Duncanla/SCI-BREADBRD-MVK/SCI-BREADBRD_avdd.sch

## KiCad design SCI-BREADBRD_avdd.sch (2012-05-08)

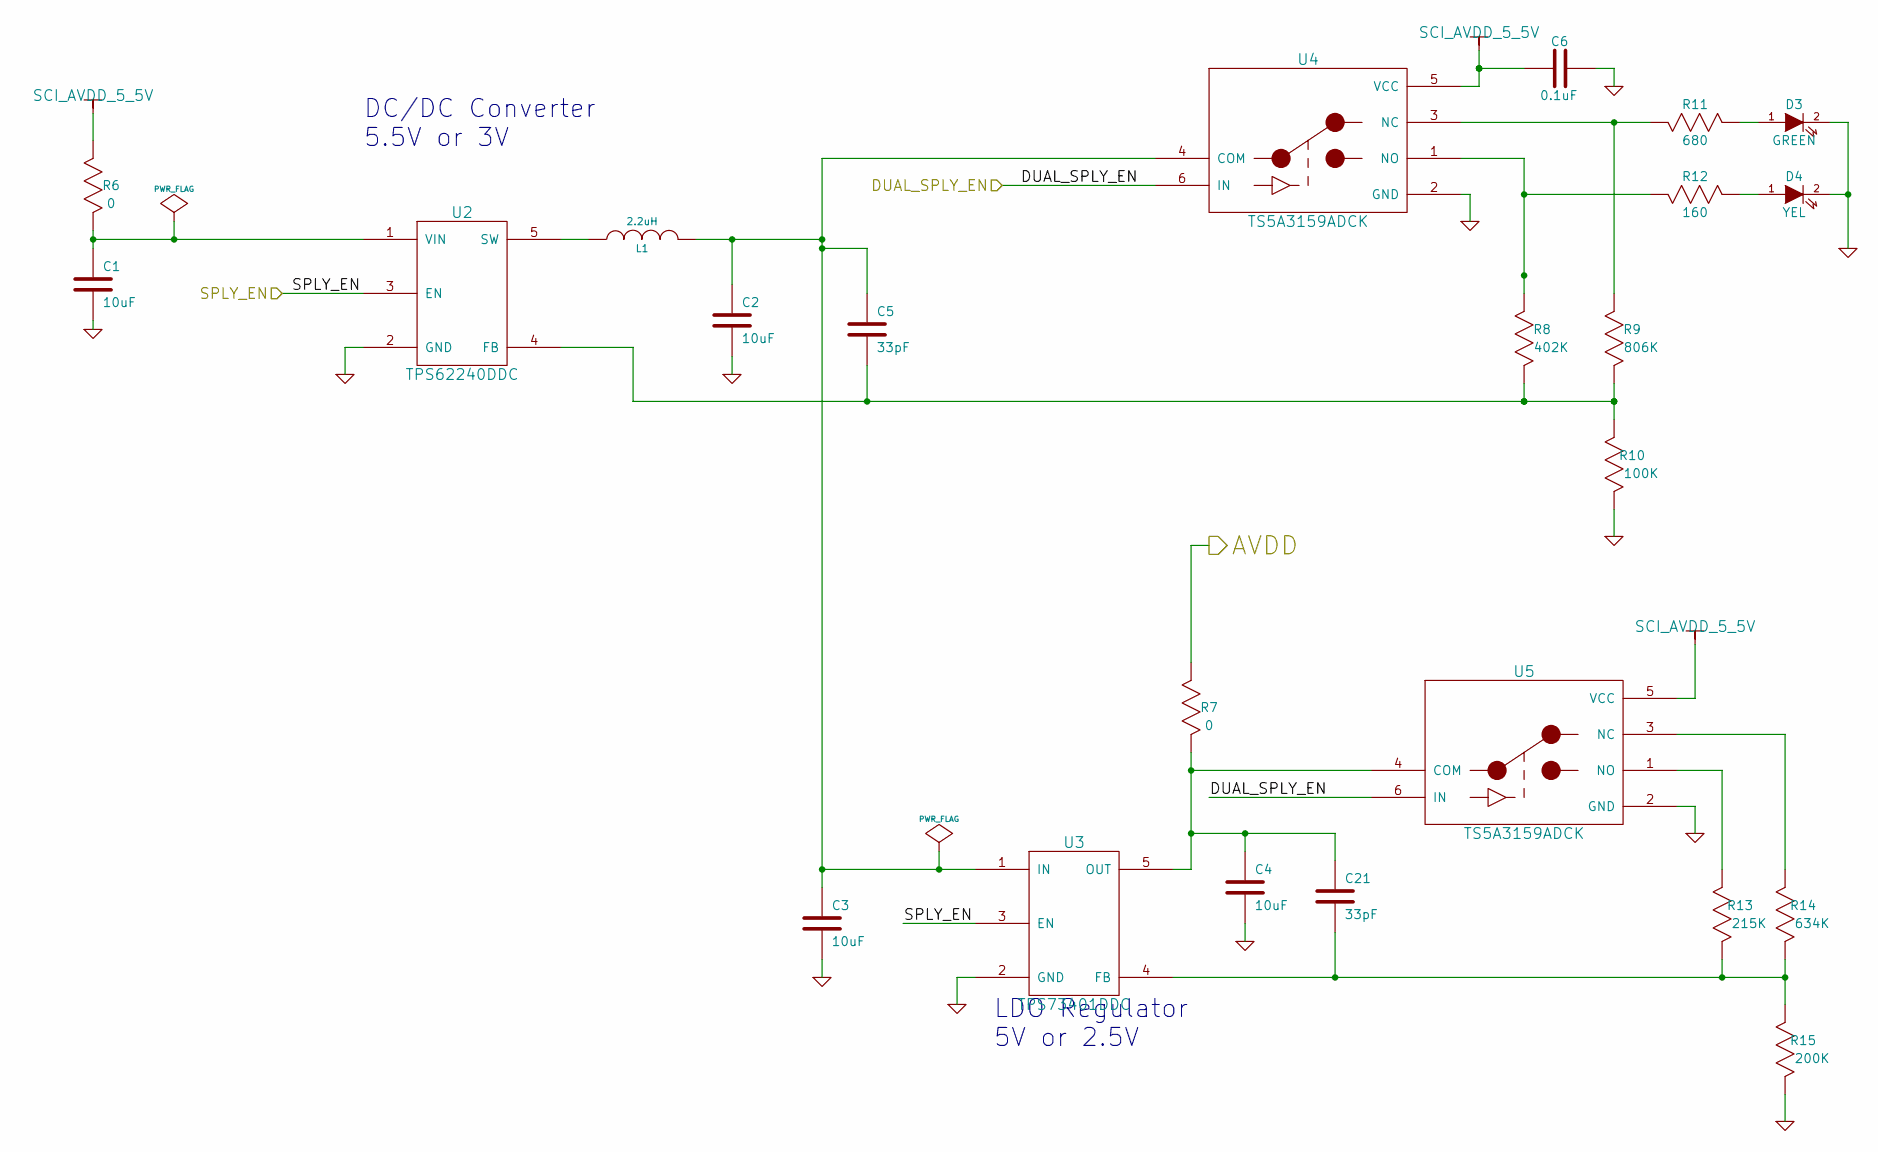
[picture p1: schematic SCI-BREADBRD_avdd.sch]

Parts:
C1, C2, C3, C4: 10uF; 0603; Part Number GRM188R60J106ME47D
C5, C21: 33pF; 0402; Part Number UMK105CG330JV-F
C6: 0.1uF; 0402; Part Number LMK105BJ104KV-F
D3: GREEN; 0402; Part Number SML-P12PTT86
D4: YEL; 0402; Part Number SML-P12YTT86
L1: 2.2uH; 1008; Part Number LQM2HPN2R2MG0L
R6, R7: 0; 0603; Part Number ERJ-3GEY0R00V
R8: 402K; 0402; Part Number ERJ-2RKF4023X
R9: 806K; 0402; Part Number ERJ-2RKF8063X
R10: 100K; 0402; Part Number ERJ-2RKF1003X
R11: 680; 0402; Part Number ERJ-2GEJ681X
R12: 160; 0402; Part Number ERJ-2GEJ161X
R13: 215K; 0402; Part Number ERJ-2RKF2153X
R14: 634K; 0402; Part Number ERJ-2RKF6343X
R15: 200K; 0402; Part Number ERJ-2RKF2003X
U2: TPS62240DDC; SOP_5_DDC; Part Number TPS62240DDCT
U3: TPS73401DDC; SOP_5_DDC; Part Number TPS73401DDCT
U4, U5: TS5A3159ADCK; SOP_6_DCK; Part Number TS5A3159ADCKR

Connections:
AVDD: R7.2 (B)
DUAL_SPLY_EN: U4.6 (IN), U5.6 (IN)
GND: C1.2, C2.2, C3.2, C4.2, C6.2, D3.2 (K), D4.2 (K), R10.1 (A), R15.1 (A), U2.2 (GND), U3.2 (GND), U4.2 (GND), U5.2 (GND)
unnamed: C1.1, R6.1 (A), U2.1 (VIN)
unnamed: C2.1, C3.1, C5.1, L1.2, U3.1 (IN), U4.4 (COM)
unnamed: C5.2, R8.1 (A), R9.1 (A), R10.2 (B), U2.4 (FB)
unnamed: C4.1, C21.1, R7.1 (A), U3.5 (OUT), U5.4 (COM)
unnamed: C21.2, R13.1 (A), R14.1 (A), R15.2 (B), U3.4 (FB)
unnamed: D3.1 (A), R11.2 (B)
unnamed: D4.1 (A), R12.2 (B)
unnamed: L1.1, U2.5 (SW)
unnamed: R9.2 (B), R11.1 (A), U4.3 (NC)
unnamed: R8.2 (B), R12.1 (A), U4.1 (NO)
unnamed: R13.2 (B), U5.1 (NO)
unnamed: R14.2 (B), U5.3 (NC)
SCI_AVDD_5_5V: C6.1, R6.2 (B), U4.5 (VCC), U5.5 (VCC)
SPLY_EN: U2.3 (EN), U3.3 (EN)

Notes on the sheet:
DC/DC Converter 5.5V or 3V
LDO Regulator 5V or 2.5V
