Duncanla/SCI-BREADBRD-MVK/SCI-BREADBRD_avss.sch

## KiCad design SCI-BREADBRD_avss.sch (2012-05-08)

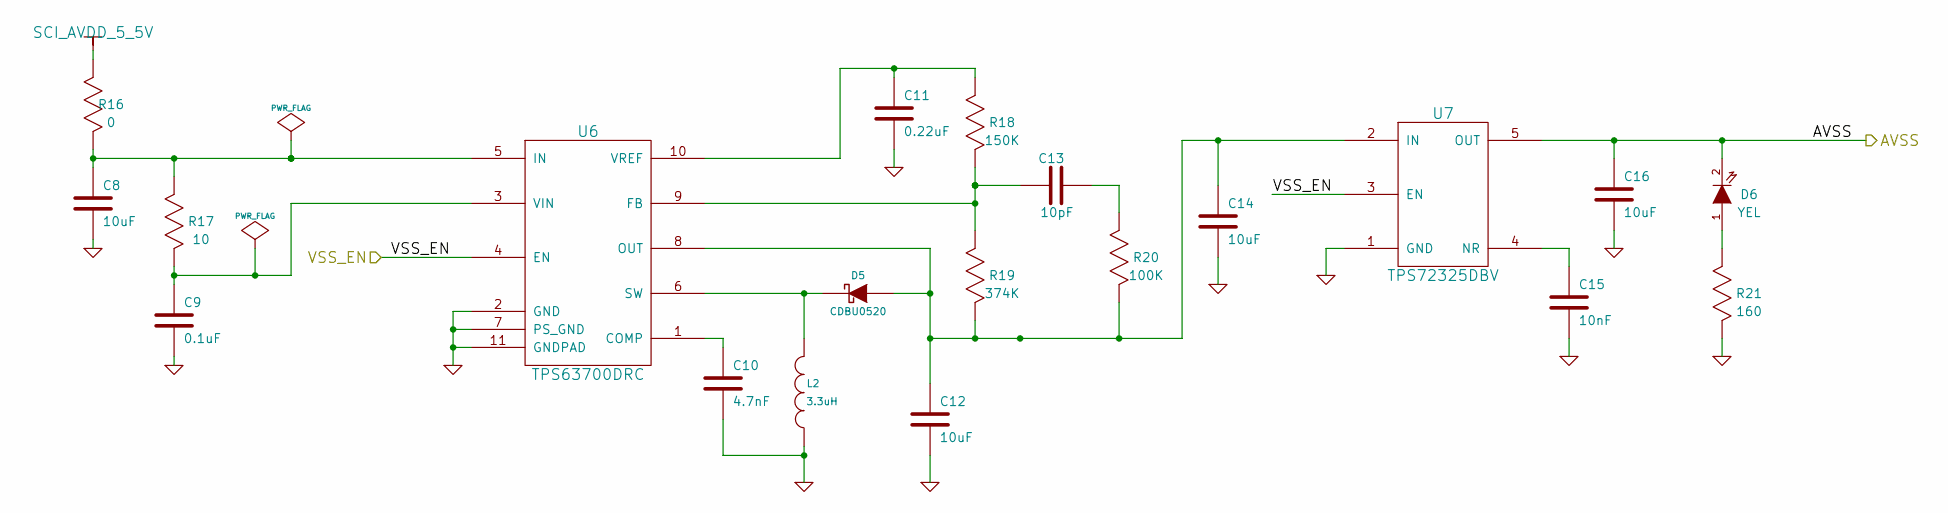
[picture p2: schematic SCI-BREADBRD_avss.sch]

Parts:
C8, C12, C14, C16: 10uF; 0603; Part Number GRM188R60J106ME47D
C9: 0.1uF; 0402; Part Number LMK105BJ104KV-F
C10: 4.7nF; 0402; Part Number UMK105B7472KV-F
C11: 0.22uF; 0402; Part Number EMK105BJ224KV-F
C13: 10pF; 0402; Part Number GRM1555C1H100JZ01D
C15: 10nF; 0402; Part Number UMK105B7102KV-F
D5: CDBU0520; 0603; Part Number CDBU0520
D6: YEL; 0402; Part Number SML-P12YTT86
L2: 3.3uH; 0806; Part Number CB2016T3R3M
R16: 0; 0603; Part Number ERJ-3GEY0R00V
R17: 10; 0402; Part Number ERJ-2GEJ100X
R18: 150K; 0402; Part Number ERJ-2RKF1503X
R19: 374K; 0402; Part Number ERJ-2RKF3743X
R20: 100K; 0402; Part Number ERJ-2GEJ104X
R21: 160; 0402; Part Number ERJ-2GEJ161X
U6: TPS63700DRC; SON10_PowerPad_10; Part Number TPS63700DRCT
U7: TPS72325DBV; SOP_5_DBV; Part Number TPS72325DBVT

Connections:
AVSS: C16.1, D6.2 (K), U7.5 (OUT)
GND: C8.2, C9.2, C10.2, C11.2, C12.2, C14.2, C15.2, C16.2, L2.1, R21.1 (A), U6.2 (GND), U6.7 (PS_GND), U6.11 (GNDPAD), U7.1 (GND)
unnamed: C8.1, R16.1 (A), R17.2 (B), U6.5 (IN)
unnamed: C9.1, R17.1 (A), U6.3 (VIN)
unnamed: C10.1, U6.1 (COMP)
unnamed: C11.1, R18.2 (B), U6.10 (VREF)
unnamed: C12.1, C14.1, D5.1 (A), R19.1 (A), R20.1 (A), U6.8 (OUT), U7.2 (IN)
unnamed: C13.1, R18.1 (A), R19.2 (B), U6.9 (FB)
unnamed: C13.2, R20.2 (B)
unnamed: C15.1, U7.4 (NR)
unnamed: D5.2 (K), L2.2, U6.6 (SW)
unnamed: D6.1 (A), R21.2 (B)
SCI_AVDD_5_5V: R16.2 (B)
VSS_EN: U6.4 (EN), U7.3 (EN)
