Duncanla/SCI-BREADBRD-MVK/SCI-BREADBRD_ext_pwr.sch

## KiCad design SCI-BREADBRD_ext_pwr.sch (2012-05-08)

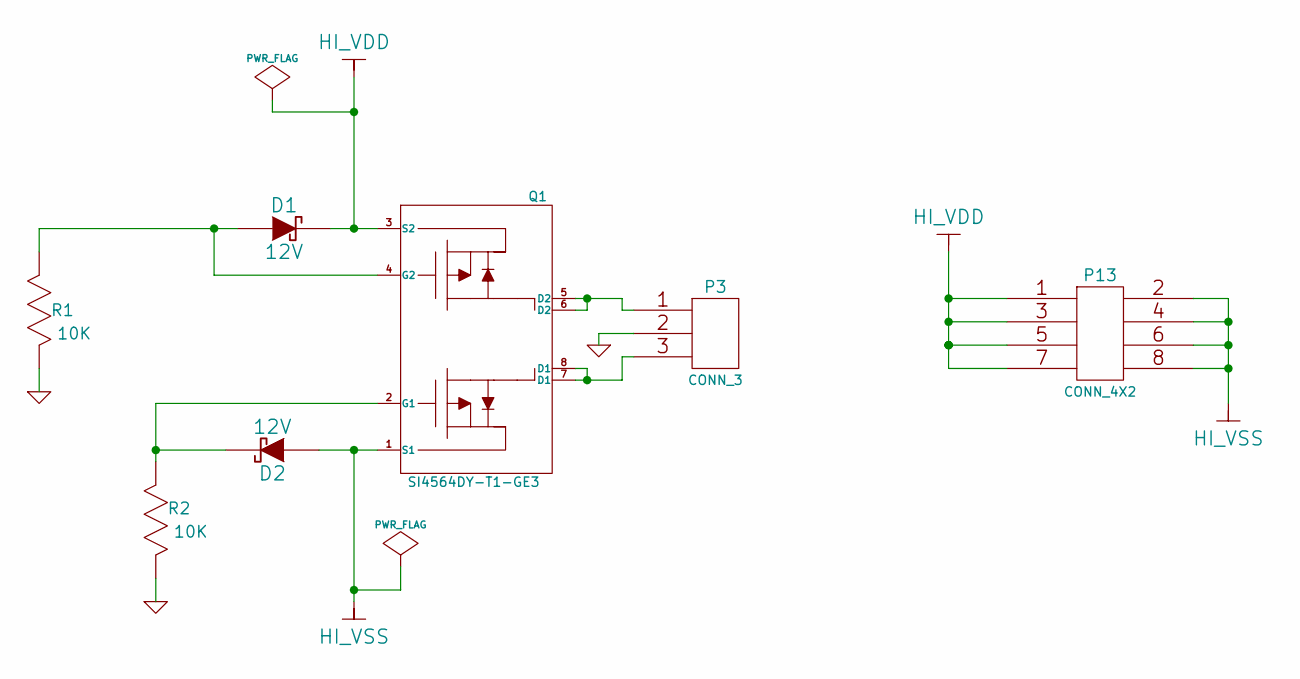
[picture p3: schematic SCI-BREADBRD_ext_pwr.sch]

Parts:
D1, D2: 12V; SOT_23_ON; Part Number BZX84C12LT1G
P3: CONN_3; PIN_ARRAY_1x3_TERMBLOCK; Part Number 282834-3
P13: CONN_4X2; pin_array_4x2; Part Number 5-534206-4
Q1: SI4564DY-T1-GE3; SOP_8_VISHAY; Part Number SI4564DY-T1-GE3
R1, R2: 10K; 0402; Part Number ERJ-2GEJ103X

Connections:
GND: P3.2 (PM), R1.1 (A), R2.1 (A)
HI_VDD: D1.2 (K), P13.1, P13.3, P13.5, P13.7, Q1.3 (S2)
HI_VSS: D2.1 (A), P13.2, P13.4, P13.6, P13.8, Q1.1 (S1)
unnamed: D1.1 (A), Q1.4 (G2), R1.2 (B)
unnamed: D2.2 (K), Q1.2 (G1), R2.2 (B)
unnamed: P3.1, Q1.5 (D2), Q1.6 (D2)
unnamed: P3.3, Q1.7 (D1), Q1.8 (D1)
