Duncanla/SCI-BREADBRD-MVK/SCI-BREADBRD_power.sch

## KiCad design SCI-BREADBRD_power.sch (2012-05-08)

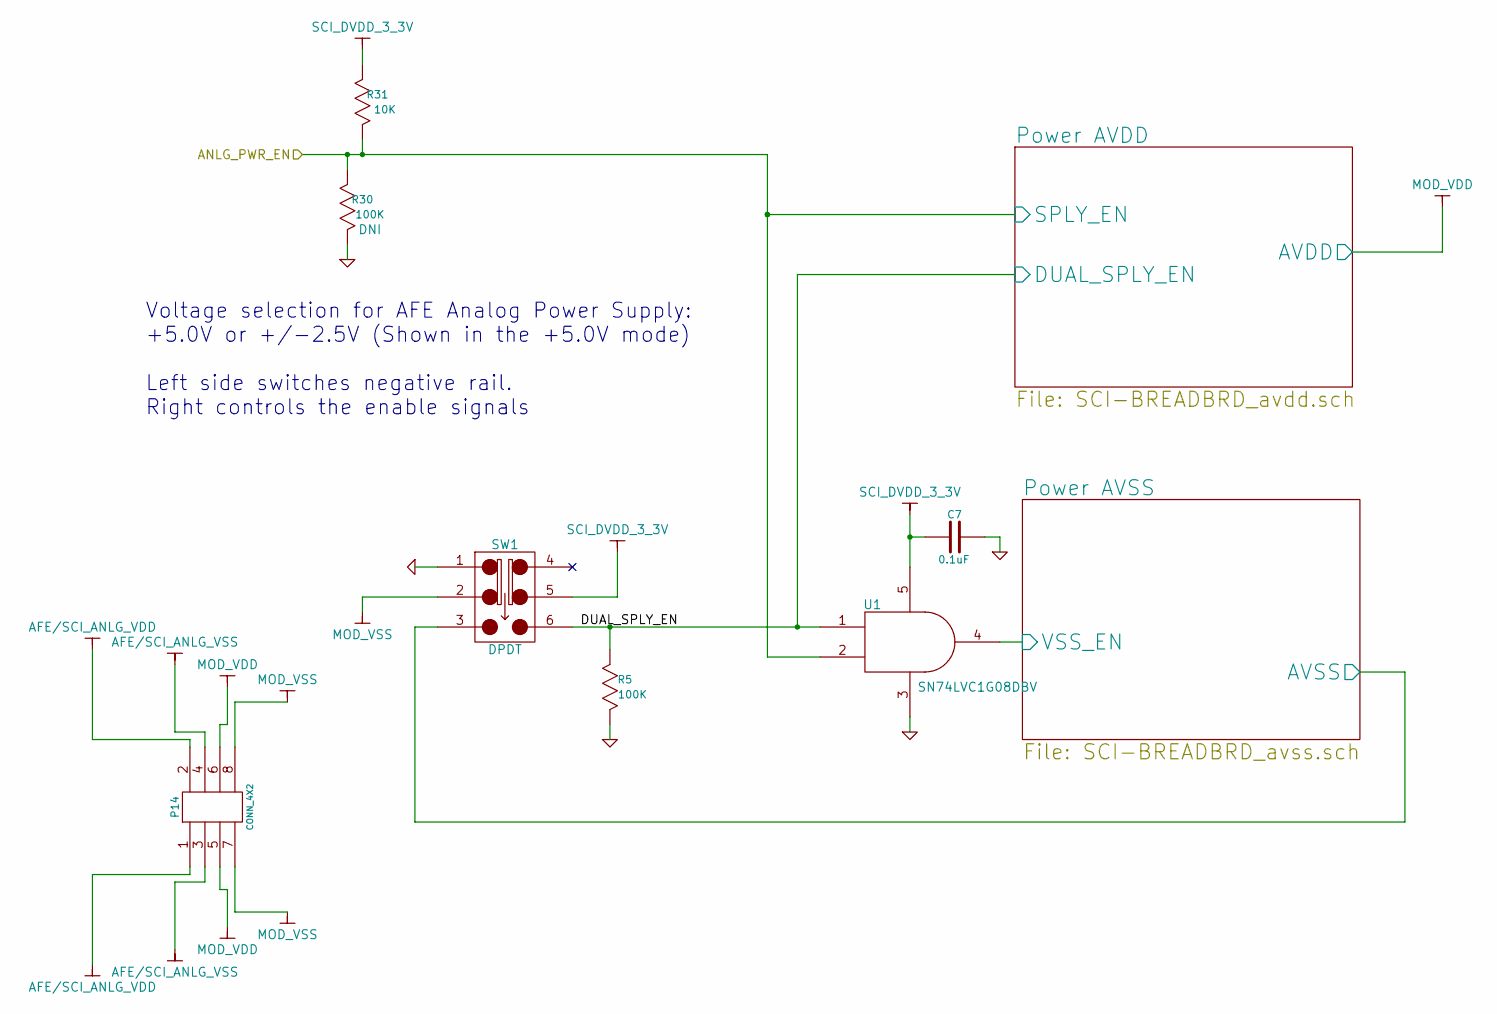
[picture p4: schematic SCI-BREADBRD_power.sch]

Parts:
C7: 0.1uF; 0402; Part Number LMK105BJ104KV-F
P14: CONN_4X2; pin_array_4x2; Part Number 5-534206-4
R5, R30: 100K; 0402; Part Number ERJ-2GEJ104X
R31: 10K; 0402; Part Number ERJ-2GEJ103X
SW1: DPDT; CK_DPDT_SMT; Part Number JS202011SCQN
U1: SN74LVC1G08DBV; SOP_5_DBV; Part Number SN74LVC1G08DBVR

Connections:
AFE/SCI_ANLG_VDD: P14.1, P14.2
AFE/SCI_ANLG_VSS: P14.3, P14.4
ANLG_PWR_EN: R30.2 (B), R31.1 (A), U1.2
AVSS: SW1.3
DUAL_SPLY_EN: R5.2 (B), SW1.6, U1.1
GND: C7.2, R5.1 (A), R30.1 (A), SW1.1, U1.3
MOD_VDD: P14.5, P14.6
MOD_VSS: P14.7, P14.8, SW1.2
SCI_DVDD_3_3V: C7.1, R31.2 (B), SW1.5, U1.5
VSS_EN: U1.4

Notes on the sheet:
Voltage selection for AFE Analog Power Supply: +5.0V or +/-2.5V (Shown in the +5.0V mode) Left side switches negative rail. Right controls the enable signals
