Duncanla/SCI-BREADBRD-MVK/SCI-BREADBRD_power_conn.sch

## KiCad design SCI-BREADBRD_power_conn.sch (2012-05-08)

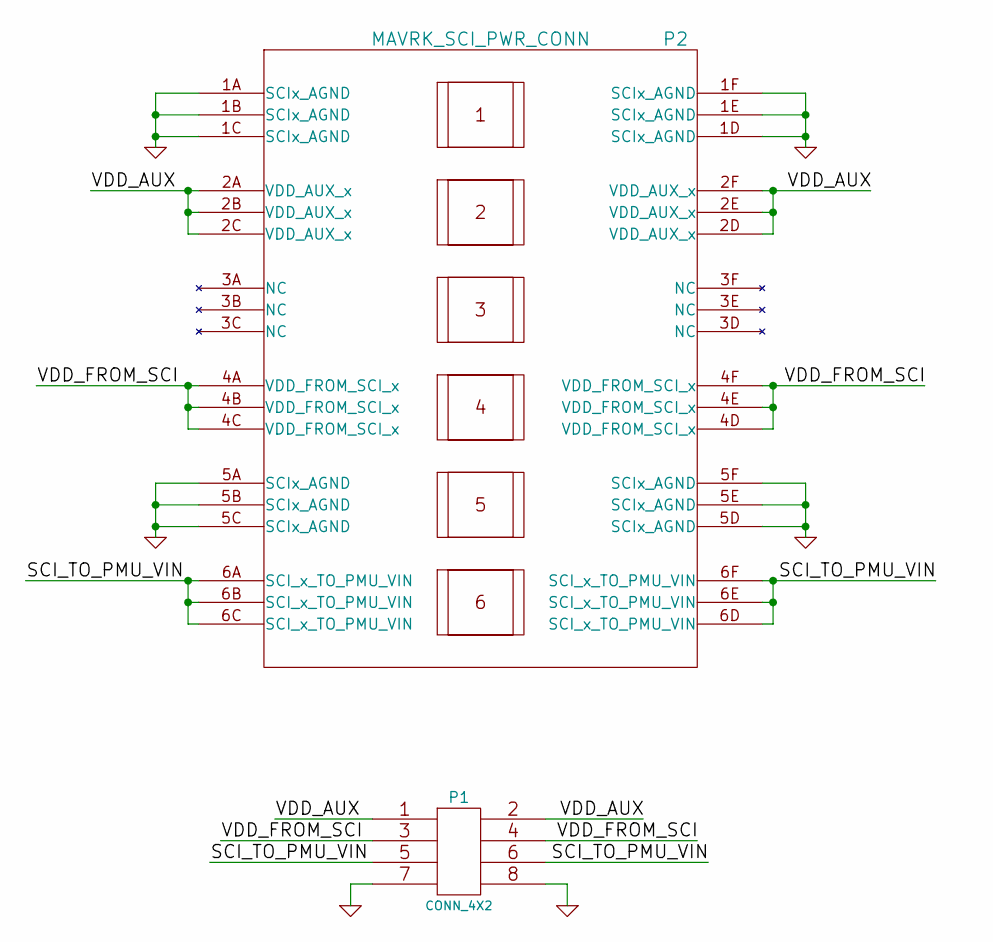
[picture p5: schematic SCI-BREADBRD_power_conn.sch]

Parts:
P1: CONN_4X2; pin_array_4x2; Part Number 5-534206-4
P2: MAVRK_SCI_PWR_CONN; SAMTEC_UPT-06-03_0-01-L-V; Part Number UPT-06-03.0-01-L-V

Connections:
GND: P1.7, P1.8, P2.1A (SCIx_AGND), P2.1B (SCIx_AGND), P2.1C (SCIx_AGND), P2.1D (SCIx_AGND), P2.1E (SCIx_AGND), P2.1F (SCIx_AGND), P2.5A (SCIx_AGND), P2.5B (SCIx_AGND), P2.5C (SCIx_AGND), P2.5D (SCIx_AGND), P2.5E (SCIx_AGND), P2.5F (SCIx_AGND)
SCI_TO_PMU_VIN: P1.5, P1.6, P2.6A (SCI_x_TO_PMU_VIN), P2.6B (SCI_x_TO_PMU_VIN), P2.6C (SCI_x_TO_PMU_VIN), P2.6D (SCI_x_TO_PMU_VIN), P2.6E (SCI_x_TO_PMU_VIN), P2.6F (SCI_x_TO_PMU_VIN)
VDD_AUX: P1.1, P1.2, P2.2A (VDD_AUX_x), P2.2B (VDD_AUX_x), P2.2C (VDD_AUX_x), P2.2D (VDD_AUX_x), P2.2E (VDD_AUX_x), P2.2F (VDD_AUX_x)
VDD_FROM_SCI: P1.3, P1.4, P2.4A (VDD_FROM_SCI_x), P2.4B (VDD_FROM_SCI_x), P2.4C (VDD_FROM_SCI_x), P2.4D (VDD_FROM_SCI_x), P2.4E (VDD_FROM_SCI_x), P2.4F (VDD_FROM_SCI_x)
