Duncanla/SCI-BREADBRD-MVK/SCI-BREADBRD_sci_conn.sch

## KiCad design SCI-BREADBRD_sci_conn.sch (2012-05-08)

Schematic: SCI-BREADBRD_sci_conn.sch

Parts:
P4: MARK_SCI_CONN; SAMTEC_QRM8-026-02_0-L-D-A; Part Number QRM8-026-02.0-L-D-A
P5: CONN_16; PIN_ARRAY_1x16; Part Number 960116-6202-AR
P6, P7: CONN_8X2; PIN_ARRAY_2x8; Part Number 929975-01-08
R3, R4: 0.10; 0805; Part Number PT0805FR-7W0R1L
