Duncanla/SCI-BREADBRD-MVK/SCI-BREADBRD_vref.sch

## KiCad design SCI-BREADBRD_vref.sch (2012-05-08)

Schematic: SCI-BREADBRD_vref.sch

Parts:
C17, C18, C19, C20: 0.1uF; 0402; Part Number C1005X6S1H104K
P10, P11: TP; TESTVIA_p30mil_h20mil
P12: CONN_1X2; PIN_ARRAY_2X1; Part Number 960102-6202-AR
R22, R23, R24, R25: 15K; 1210; Part Number ERA-14EB153U
R26, R27, R28, R29: 10K; 0402; Part Number ERJ-2GEJ103X
U8, U9: OPA454AIDDA; SOP_8_PowerPad_DDA; Part Number OPA454AIDDA
