Duncanla/SCI-BREADBRD-MVK/(commit log)

2012-04-27 Fixed the footprint properties of various parts throughout the schematic to make sure they are all point to valid footprints.
    Added SCI-BREADBRD.cmp to specify which footprints should be used for
    each part.
    Added netlists to the .gitignore as those can be generated easily in
    eeschema.
    [SCI-BREADBRD.sch, SCI-BREADBRD_avdd.sch, SCI-BREADBRD_avss.sch, SCI-BREADBRD_connectors.sch, SCI-BREADBRD_ext_pwr.sch, SCI-BREADBRD_power.sch, SCI-BREADBRD_power_conn.sch, SCI-BREADBRD_sci_conn.sch]
2012-04-27 Changed library path to the local directory. Component and module dirs should be linked to the root of the repository.
    For instance:
    ln -s /path/to/kicad-components \
    /path/to/SCI-BREADBRD-MVK/kicad-components
    ln -s /path/to/kicad-modules \
    /path/to/SCI-BREADBRD-MVK/kicad-modules
    [SCI-BREADBRD.sch, SCI-BREADBRD_avdd.sch, SCI-BREADBRD_avss.sch, SCI-BREADBRD_connectors.sch, SCI-BREADBRD_ext_pwr.sch, SCI-BREADBRD_power.sch, SCI-BREADBRD_power_conn.sch, SCI-BREADBRD_sci_conn.sch]
2012-04-27 Completed ERC. Added some power flags and fixed mis-connected pins.
    [SCI-BREADBRD.sch, SCI-BREADBRD_avdd.sch, SCI-BREADBRD_avss.sch, SCI-BREADBRD_connectors.sch, SCI-BREADBRD_ext_pwr.sch, SCI-BREADBRD_power.sch, SCI-BREADBRD_power_conn.sch, SCI-BREADBRD_sci_conn.sch]
2012-04-27 Added kicad-components as a git submodule
2012-04-27 Updated kicad-components
2012-04-27 Add kicad-modules as a git submodule
2012-04-27 Fixed component properties to make the BOM look nicer
    [SCI-BREADBRD_power.sch, SCI-BREADBRD_sci_conn.sch]
2012-04-27 Fixed more component properties to make the BOM look nice
    [SCI-BREADBRD_ext_pwr.sch, SCI-BREADBRD_sci_conn.sch]
2012-04-27 Changed the testpoints to have a refdes of TP? instead of P? and re-annotated.
    Fixed a but in better_bom that was causing the last field to be
    erroneous.
    Added the -e option to better_bom to allow excluding fields
    [SCI-BREADBRD.sch, SCI-BREADBRD_avdd.sch, SCI-BREADBRD_avss.sch, SCI-BREADBRD_connectors.sch, SCI-BREADBRD_ext_pwr.sch, SCI-BREADBRD_power.sch, SCI-BREADBRD_power_conn.sch, SCI-BREADBRD_sci_conn.sch]
2012-04-27 Added SCI-BREADBRD*.ps files to .gitignore to ignore schematic plots
2012-04-27 Shifted some of the circuits to fit better on each page
    [SCI-BREADBRD_avdd.sch, SCI-BREADBRD_power.sch]
2012-04-27 Enlarged the text on all of the power rails to make them easier to see when plotted
    [SCI-BREADBRD.sch, SCI-BREADBRD_avdd.sch, SCI-BREADBRD_avss.sch, SCI-BREADBRD_connectors.sch, SCI-BREADBRD_ext_pwr.sch, SCI-BREADBRD_power.sch, SCI-BREADBRD_power_conn.sch, SCI-BREADBRD_sci_conn.sch]
2012-04-27 Made font bigger on power symbols.
2012-05-01 Added breakout connector for external power. Removed useless jumpers to select between external/internal power
    [SCI-BREADBRD_ext_pwr.sch]
2012-05-02 No longer connecting the power circuitry directly to AFE/SCI_ANLG power rails.
    This is just too dangerous with AFE modules that also generate power
    on those rails. For this board, the user can manually jumper the
    circuitry to the rails as desired.
    [SCI-BREADBRD_avdd.sch, SCI-BREADBRD_power.sch]
2012-05-02 Re-annotated for added parts.
    [SCI-BREADBRD.sch, SCI-BREADBRD_avdd.sch, SCI-BREADBRD_avss.sch, SCI-BREADBRD_connectors.sch, SCI-BREADBRD_ext_pwr.sch, SCI-BREADBRD_power.sch, SCI-BREADBRD_power_conn.sch, SCI-BREADBRD_sci_conn.sch]
2012-05-02 Started board layout.
    [SCI-BREADBRD.brd]
2012-05-02 Added letters to pin names for the SAMTEC_UPT connector.
2012-05-03 Added some bypass caps. Rearranged pins on connectors to make layout easier.
    [SCI-BREADBRD.sch, SCI-BREADBRD_avdd.sch, SCI-BREADBRD_avss.sch, SCI-BREADBRD_connectors.sch, SCI-BREADBRD_ext_pwr.sch, SCI-BREADBRD_power.sch, SCI-BREADBRD_power_conn.sch, SCI-BREADBRD_sci_conn.sch]
2012-05-03 Initial placement for layout
    [SCI-BREADBRD.brd]
2012-05-05 More layout progress
    [SCI-BREADBRD.brd, SCI-BREADBRD.sch, SCI-BREADBRD_avdd.sch, SCI-BREADBRD_avss.sch, SCI-BREADBRD_connectors.sch, SCI-BREADBRD_ext_pwr.sch, SCI-BREADBRD_power.sch, SCI-BREADBRD_power_conn.sch]
2012-05-08 Finished initial PCB layout
    [SCI-BREADBRD.brd, SCI-BREADBRD.sch, SCI-BREADBRD_avdd.sch, SCI-BREADBRD_avss.sch, SCI-BREADBRD_connectors.sch, SCI-BREADBRD_ext_pwr.sch, SCI-BREADBRD_power.sch, SCI-BREADBRD_power_conn.sch]
2012-05-09 Finished silkscreen. Changed all holes to be plated.
    [SCI-BREADBRD.brd]
2012-05-09 Changed holes to plated. Added more fab files to ignore.
